Shayshez/1uO_c-mk2/README.md

# 1uO_c-mk2
Version 2 for 1uO_c, include VOR system and front usb

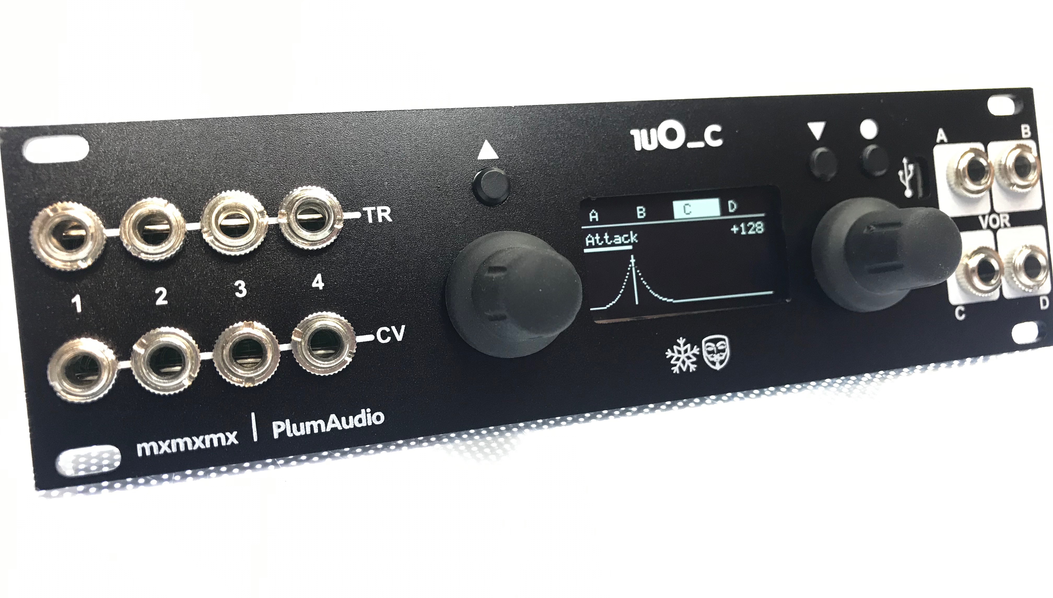
[picture p1: 1UO_C-MK2.jpeg]
1uO_c
