Shayshez/1uO_c-mk2/1uO_c_2.2_BOM.xlsx

Qty | Value | Device | Package | Parts | Description | MOUSER_PART_NUMBER | ARROW_PRICE-STOCK | AVAILABILITY | DESCRIPTION | HEIGHT | MANUFACTURER_NAME | MANUFACTURER_PART_NUMBER | MF | MP | MPN | PACKAGE | PRICE | RS_PART_NUMBER | RS_PRICE-STOCK | SPICEPREFIX | VALUE | WE-NUMBER
 | Resistors 0603 1%
6 | 100R | R-EU_R0603 | R0603 | R23, R25, R33, R41, R44, R45 | RESISTOR, European symbol | 603-RC0603FR-07100RL |  |  |  |  |  |  |  |  |  |  |  |  |  | R
4 | 220R | R-EU_R0603 | R0603 | R1, R3, R5, R6 | RESISTOR, European symbol | 603-RC0603FR-07220RL |  |  |  |  |  |  |  |  |  |  |  |  |  | R
3 | 510R | R-EU_R0603 | R0603 | R15, R17, R47 | RESISTOR, European symbol | 603-RC0603FR-07510RL |  |  |  |  |  |  |  |  |  |  |  |  |  | R
1 | 2K | R-EU_R0603 | R0603 | R18 | RESISTOR, European symbol | 603-RC0603FR-072KL |  |  |  |  |  |  |  |  |  |  |  |  |  | R
2 | 10k | R-EU_R0603 | R0603 | R13, R43 | RESISTOR, European symbol | 603-AC0603FR-1010KL |  |  |  |  |  |  |  |  |  |  |  |  |  | R
4 | 24K | R-EU_R0603 | R0603 | R9, R10, R11, R12 | RESISTOR, European symbol | 603-RC0603FR-0724KL |  |  |  |  |  |  |  |  |  |  |  |  |  | R
8 | 33K | R-EU_R0603 | R0603 | R20, R22, R27, R30, R32, R35, R36, R40 | RESISTOR, European symbol | 603-RC0603FR-1333KL |  |  |  |  |  |  |  |  |  |  |  |  |  | R
5 | 75K | R-EU_R0603 | R0603 | R14, R21, R28, R39, R42 | RESISTOR, European symbol | 603-AC0603FR-0775KL |  |  |  |  |  |  |  |  |  |  |  |  |  | R
13 | 100K | R-EU_R0603 | R0603 | R2, R4, R7, R8, R16, R19, R24, R26, R29, R31, R34, R37, R38 | RESISTOR, European symbol | 603-RC0603FR-07100KL |  |  |  |  |  |  |  |  |  |  |  |  |  | R
 | Caps MLCC
4 | 22p | C-EUC0603 | C0603 | C5, C6, C11, C12 | CAPACITOR, European symbol | 80-C0603C220J5G7411 (https://www.mouser.co.il/ProductDetail/KEMET/C0603C220J5GAC7411?qs=sGAEpiMZZMtJOOgnx%2fXJmejeuawQ%252btGe)
4 | 560p | C-EUC0603 | C0603 | C31, C32, C34, C35 | CAPACITOR, European symbol | 581-06035A561G
17 | 100n | C-EUC0603 | C0603 | C7, C8, C9, C10, C13, C14, C15, C17, C18, C19, C20, C25, C26, C29, C30, C33, C37 | CAPACITOR, European symbol | 80-C0603C104K3NAUTO (https://www.mouser.co.il/ProductDetail/KEMET/C0603C104K3NACAUTO)
3 | 470n | C-EUC0603 | C0603 | C16, C21, C22 | CAPACITOR, European symbol | 963-UMK107B7474KA-TR (https://www.mouser.co.il/ProductDetail/TDK/CGA3E3X7R1H474K080AB)
2 | 1uF | C-EUC0603 | C0603 | C27, C28 | CAPACITOR, European symbol | 603-CC603KRX5R8BB105 (https://www.mouser.co.il/ProductDetail/Yageo/CC0603KRX5R8BB105)
1 | 10uF | C-EUC0603 | C0603 | C36 | CAPACITOR, European symbol | 810-C1608X5R1A106K
2 | 10uF | C-EUC1206K | C1206K | C23, C24 | CAPACITOR, European symbol | 963-TMK316BJ106ML-T (https://www.mouser.co.il/ProductDetail/963-TMK316BJ106ML-T)
 | Caps Electrolytics
2 | 10uF | CPOL-EUB | PANASONIC_B | C1, C4 | POLARIZED CAPACITOR, European symbol | 667-EEE-FK1H100SR (https://www.mouser.co.il/ProductDetail/Panasonic/EEE-FK1H100SR) |  |  |  |  |  |  |  |  |  |  |  |  |  | C
1 | 10uF | CPOL-USA | PANASONIC_A | C40 | POLARIZED CAPACITOR, American symbol | 647-UWX1C100MCL2
2 | 22uF | CPOL-EUC | PANASONIC_C | C2, C3 | POLARIZED CAPACITOR, European symbol | 667-EEE-FK1H220SR (https://www.mouser.co.il/ProductDetail/Panasonic/EEE-FK1H220SR) |  |  |  |  |  |  |  |  |  |  |  |  |  | C
 | Inductor
1 | 10uH | WE-LQ_1210_744032001 | WE-LQ_M | L1 | SMD Inductor | 963-LB3218T100K (https://www.mouser.com/Search/ProductDetail.aspx) |  |  |  |  |  |  |  |  |  |  |  |  |  |  |  | 744032001/1uH
 | Chips
2 | 1N5819HW | DIODE_DIODE-SOD123 | DIODE_SOD123 | D1, D2 | DIODE | 621-1N5819HW-F (https://www.mouser.co.il/ProductDetail/Diodes-Incorporated/1N5819HW-7-F)
1 | ADP150AUJZ-3.3-R7 | ADP150AUJZ-3.3-R7 | SOT95P280X100-5N | U2 | IC REG LINEAR 2V 150MA 5TSOT | 584-ADP150AUJZ-3.3R7 |  | Good | LDO Regulator Pos 2V 0.15A 5-Pin TSOT T/R |  |  |  | Analog Devices | ADP150AUJZ-2.0-R7 |  | TSOT-23 Analog Devices | 0.65 USD
1 | DAC8565IAPW | DAC8565IAPW | SOP65P640X120-16N | U1 | Quad Channel DAC | 595-DAC8565IAPW (https://www.mouser.co.il/ProductDetail/Texas-Instruments/DAC8565IAPW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) |  | Good | 16-Bit, Quad Channel, Ultra-Low Glitch, Voltage Output DAC with 2.5V, 2ppm/C Internal eference 16-TSSOP -40 to 105 |  |  |  | Texas Instruments | DAC8565IAPW |  | TSSOP-16 Texas Instruments | 10.78 USD
1 | LD1117S50TR | LD1117S50TR | SOT223 | U3 | http://octopart.com/ld1117s50tr-stmicroelectronics-529395 | 511-LD1117S50 |  | Good | LD1117 Series 1300 mA 5 V Fixed Output Positive Voltage LDO Regulator - SOT-223 |  |  |  | STMicroelectronics | LD1117S50TR |  | SOT-223 STMicroelectronics | 0.19 USD
1 | LM321MF | LM321MF | SOT23-5 | IC7 | Low Power Single Op Amp | LM321MF/NOPB (https://www.mouser.co.il/ProductDetail/Texas-Instruments/LM321MF-NOPB?qs=sGAEpiMZZMvu8NZDyZ4K0QTEfSGysGd%252B)
1 | LM4040-5V | LM4041B12DBZ | DBZ_R-PDSO-G3 | IC3 | PRECISION MICROPOWER SHUNT VOLTAGE REFERENCE | 926-LM4040DIM350NOPB (https://www.mouser.co.il/ProductDetail/Texas-Instruments/LM4040DIM3-50-NOPB)
2 | MCP6002SMT | MCP6002SMT | SOIC8 | IC4, IC5 | Dual General Op Amp | 579-MCP6002T-I/SN (https://www.mouser.co.il/ProductDetail/Microchip-Technology/MCP6002T-I-SN?qs=sGAEpiMZZMsUzhEcHltCuY6YBL510a4u)
1 | MIC803-46D2VM3TR | MIC803-46D2VM3TR | SOT95P230X110-3N | IC6 | 3-pin Microprocessor Supervosor Circui | MIC803-46D2VM3TR |  |  | 3-pin Microprocessor Supervosor Circui | mm | Micrel | MIC803-46D2VM3TR
4 | MMBT3904LT1G | SMD-TRANSISTORS-NPN-40V-200MA-MMBT3904LT1G(SOT-23) | SOT-23 | Q1, Q2, Q3, Q4 | 305010013 | 863-MMBT3904LT1G (https://www.mouser.co.il/ProductDetail/ON-Semiconductor/MMBT3904LT1G) |  |  |  |  |  |  |  |  | MMBT3904LT1G |  |  |  |  |  | MMBT3904LT1G
2 | TL072 | TL072D | SO08 | IC1, IC2 | OP AMP | 595-TL072CDR (https://www.mouser.co.il/ProductDetail/Texas-Instruments/TL072CDR?qs=sGAEpiMZZMtYFXwiBRPs0zzUsTTH4TUq)
 | Misc
1 | 1X40 Pin Header | Theensy / OLED connector
1 | POWER HEADER 10 PINS | Pin headers 2.54mm 2X5 | POWER | J$1
2 | PEC11RPEC11R | PEC11RPEC11R | PEC11R | ENC_L, ENC_R | Incremental encoder 24 detents 24 pulses Bourns 24 Pulse Incremental Mechanical Rotary Encoder with a 6 mm Flat Shaft (Not Indexed), Through Hole | 858-EN11-HSM1BF20 (https://www.mouser.co.il/ProductDetail/858-EN11-HSM1BF20)
1 | TEENSY_3.2_USB_DAC_RESET | TEENSY_3.2_USB_DAC_RESET | TEENSY_3.2_USB_DAC_RESET | TEENSY3.2 |  | DEV-13736 (https://www.mouser.co.il/ProductDetail/SparkFun/DEV-13736?qs=sGAEpiMZZMuWWq7rhECaKVjnUlbUDjFgBj37EAXueZA%3D)
1 | USB_BOARD | USB_BOARD | MICRO-USB-BOARD | U$1
1 | USB Connector | USB Connector Type B micro, VERT - DIP | Wurth Elektronik 614105150621 | Wurth Elektronik 614105150621 | USB Connectors WR-COM USB Micro THT Type AB Vertical | 710-614105150621
3 |  | TACT Switches | E-switch TL1105SPF250Q | SW_B, SW_T, SW_VOR | Momentary Switch | 612-TL1105SP-250 (https://www.mouser.co.il/ProductDetail/612-TL1105SP-250)
3 |  | TACT Switches caps | E-switch 1RBLK | SW_B, SW_T, SW_VOR |  | 12-1R-BK (https://www.mouser.co.il/ProductDetail/612-1R-BK)
1 | Plum 1U_1.3OLED_2 | Plum 1U_1.3OLED_2 |  | OLED | https://github.com/Shayshez/1_3_OLED_FOR_1U
1 | OLED SCREEN |  |  |  | https://github.com/Shayshez/1_3_OLED_FOR_1U
12 | PJ301_THONKICONN | PJ301_THONKICONN | WQP_PJ_301M | CV1, CV2, CV3, CV4, CV_A, CV_B, CV_C, CV_D, TR1, TR2, TR3, TR4
