Shayshez/1uO_c-mk2/1uO_c_v_2.2.brd

## EAGLE design 1uO_c_v_2.2.brd (2019-11-25)

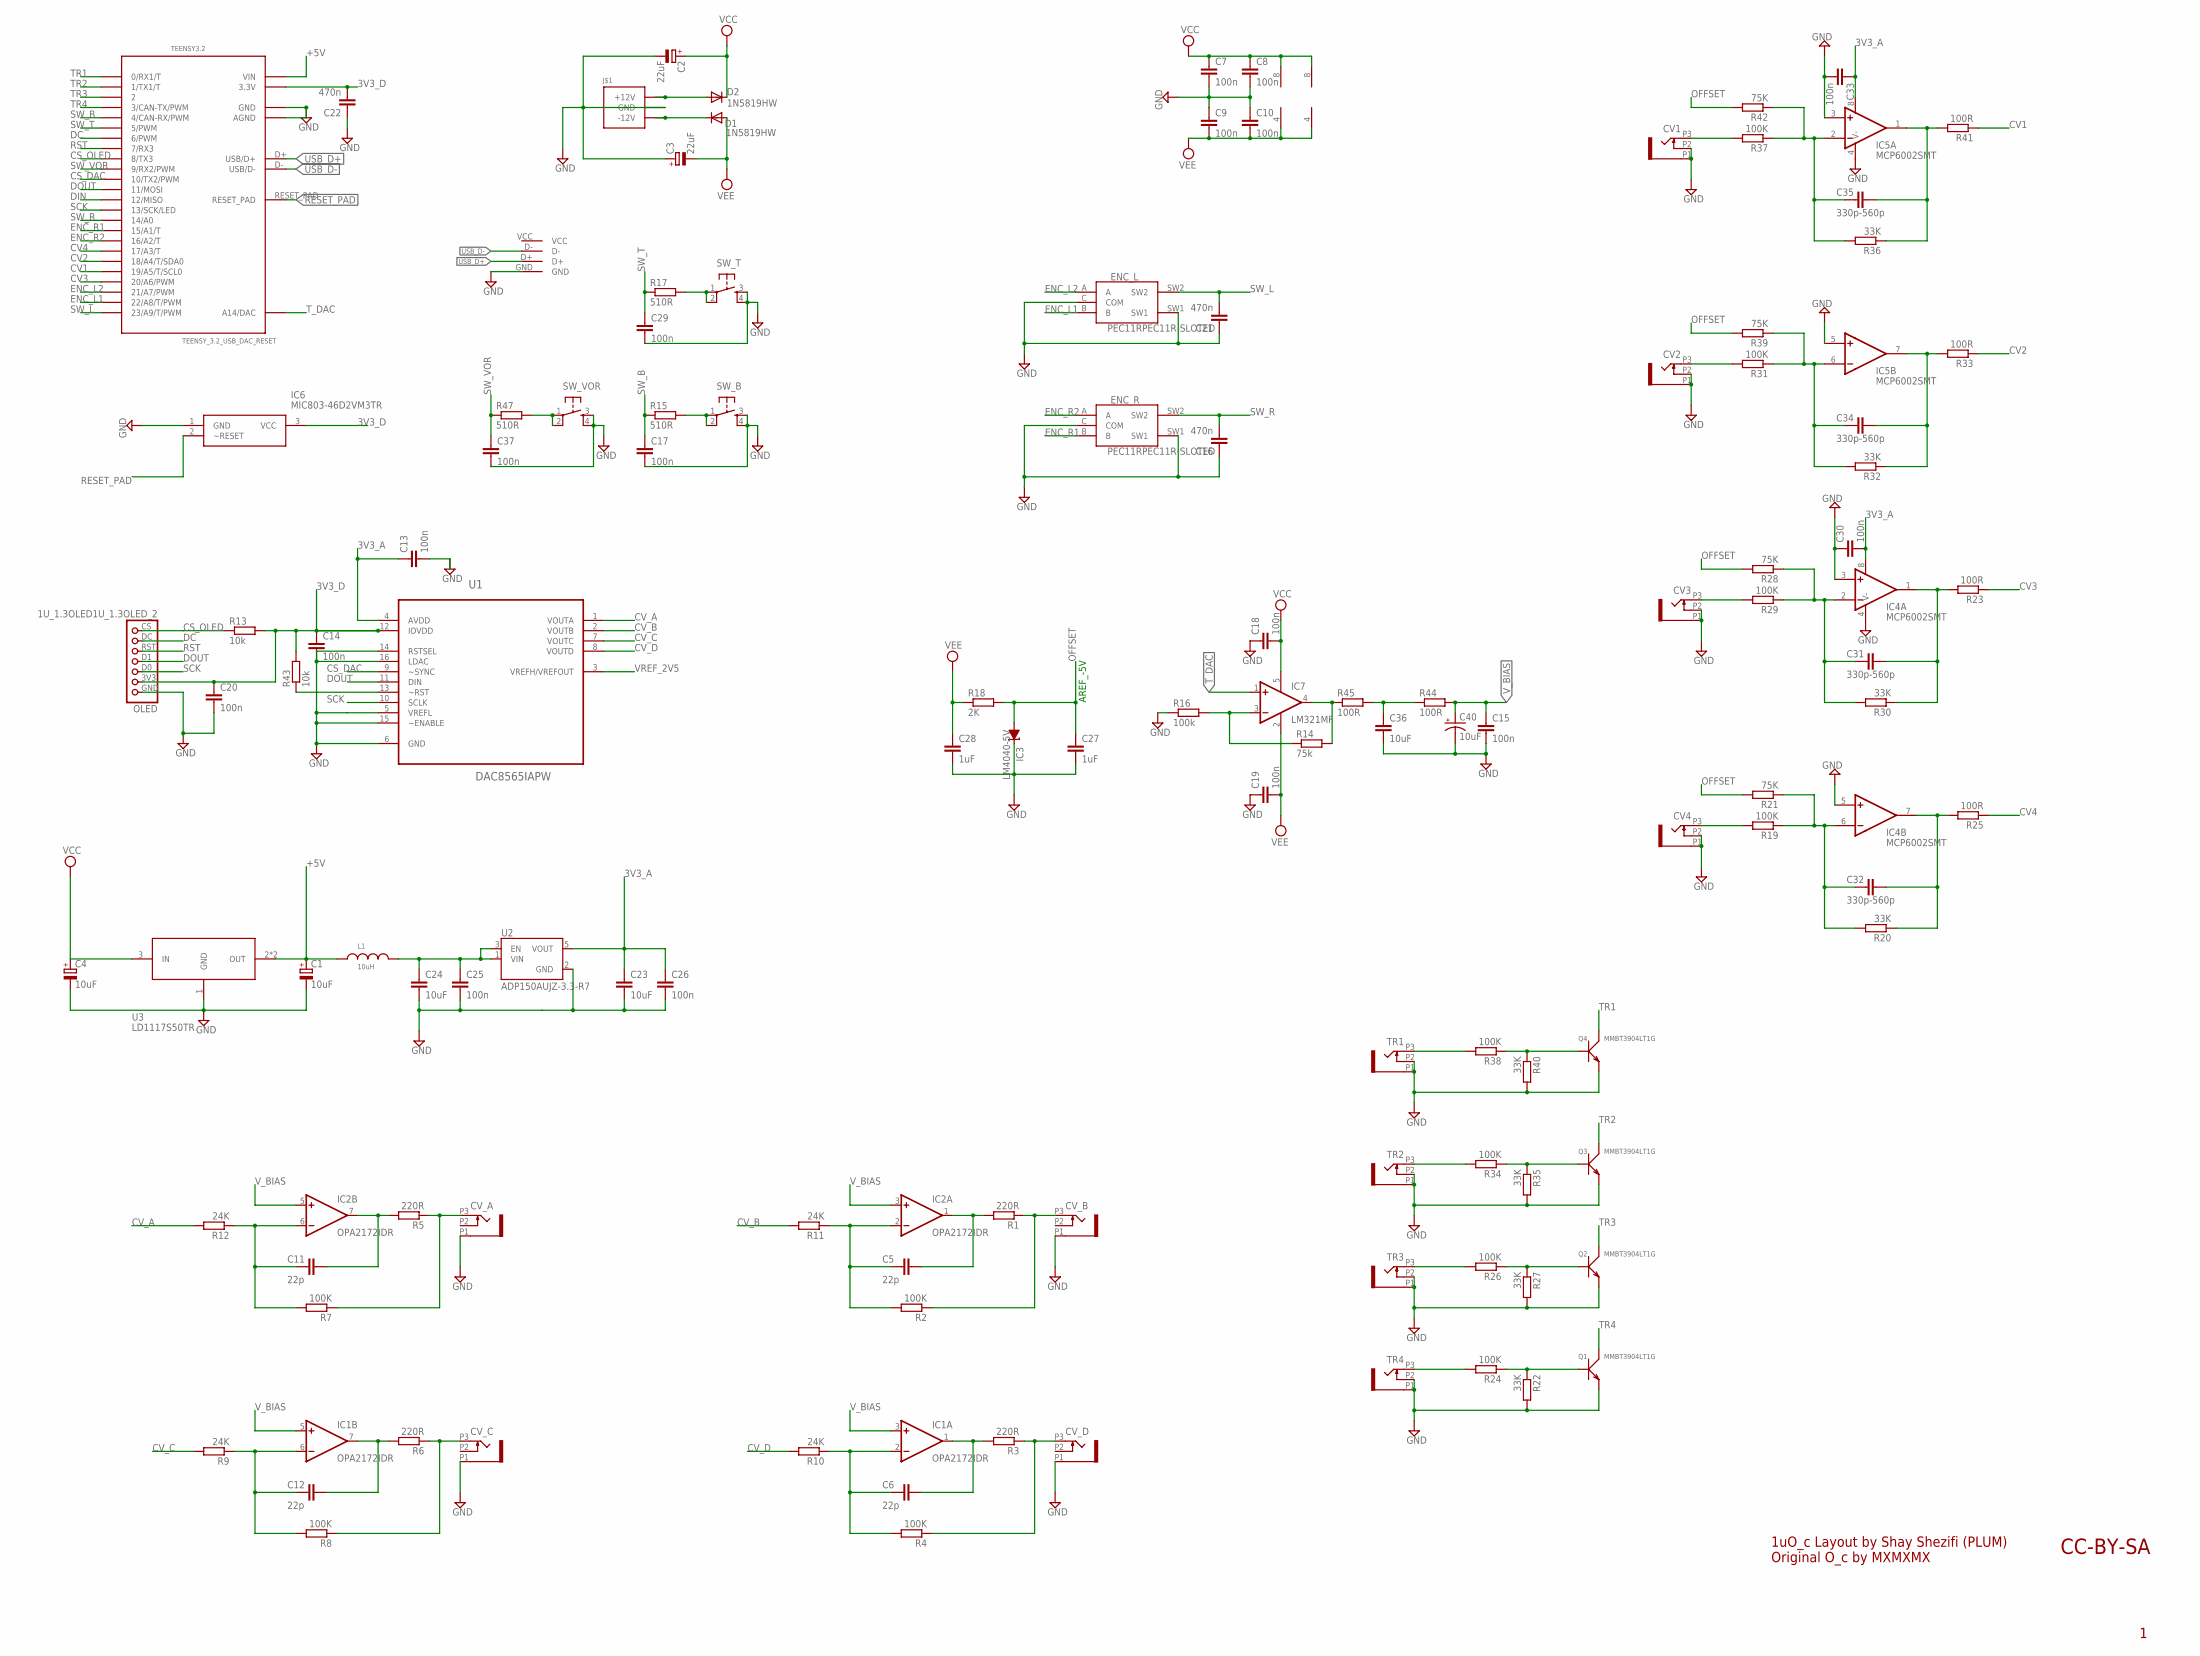
[picture p2: schematic 1uO_c_v_2.2.sch]

Parts:
C1, C4: 10uF; PANASONIC_B
C2, C3: 22uF; PANASONIC_C
C5, C6, C11, C12: 22p; C0603
C7, C8, C9, C10, C13, C14, C15, C17, C18, C19, C20, C25, C26, C29, C30, C33, C37: 100n; C0603
C16, C21, C22: 470n; C0603
C23, C24: 10uF; C1206K
C27, C28: 1uF; C0603
C31, C32, C34, C35: 330p-560p; C0603
C36: 10uF; C0603
C40: 10uF; PANASONIC_A
CV1, CV2, CV3, CV4: OG-PJ301_PJ301_THONKICONN; OG-PJ301_WQP_PJ_301M6_NO_HOLE
CV_A: OG-PJ301_PJ301_THONKICONN; OG-PJ301_WQP_PJ_301M6_NO_HOLE
CV_B: OG-PJ301_PJ301_THONKICONN; OG-PJ301_WQP_PJ_301M6_NO_HOLE
CV_C: OG-PJ301_PJ301_THONKICONN; OG-PJ301_WQP_PJ_301M6_NO_HOLE
CV_D: OG-PJ301_PJ301_THONKICONN; OG-PJ301_WQP_PJ_301M6_NO_HOLE
D1, D2: 1N5819HW; DIODE_SOD123
ENC_L: PEC11RPEC11R-SLOTED; PEC11R-SLOTED
ENC_R: PEC11RPEC11R-SLOTED; PEC11R-SLOTED
IC1, IC2: OPA2172IDR; SO08
IC3: LM4040-5V; DBZ_R-PDSO-G3
IC4, IC5: MCP6002SMT; SOIC8
IC6: MIC803-46D2VM3TR; SOT95P230X110-3N
IC7: LM321MF; SOT23-5
J$1: POWER_SIMPLE10; POWER_10
L1: 10uH; WE-LQ_M
OLED: 1U_1.3OLED1U_1.3OLED_2; 1U_1.3OLED_2
Q1, Q2, Q3, Q4: MMBT3904LT1G; SOT-23
R1, R3, R5, R6: 220R; R0603
R2, R4, R7, R8, R19, R24, R26, R29, R31, R34, R37, R38: 100K; R0603
R9, R10, R11, R12: 24K; R0603
R13, R43: 10k; R0603
R14: 75k; R0603
R15, R17, R47: 510R; R0603
R16: 100k; R0603
R18: 2K; R0603
R20, R22, R27, R30, R32, R35, R36, R40: 33K; R0603
R21, R28, R39, R42: 75K; R0603
R23, R25, R33, R41, R44, R45: 100R; R0603
SW_B: TAC_SWITCHPTH; TACTILE-PTH
SW_T: TAC_SWITCHPTH; TACTILE-PTH
SW_VOR: TAC_SWITCHPTH; TACTILE-PTH
TEENSY3.2: TEENSY_3.2_USB_DAC_RESET
TR1, TR2, TR3, TR4: OG-PJ301_PJ301_THONKICONN; OG-PJ301_WQP_PJ_301M6_NO_HOLE
U1: DAC8565IAPW; SOP65P640X120-16N
U2: ADP150AUJZ-3.3-R7; SOT95P280X100-5N
U3: LD1117S50TR; SOT223
U$1: USB_BOARD; MICRO-USB-BOARD

Connections:
3V3_A: C13.1, C23.1, C26.1, C30.2, C33.1, IC4.8 (V+), IC5.8 (V+), U1.4 (AVDD), U2.5 (VOUT)
3V3_D: C14.1, C20.1, C22.2, IC6.3 (VCC), OLED.3V3, R13.2, R43.2, TEENSY3.2.3.3V, U1.12 (IOVDD)
+5V: C1.+, L1.1, TEENSY3.2.VIN, U3.2 (OUT), U3.4 (OUT)
CS_DAC: TEENSY3.2.10 (10/TX2/PWM), U1.9 (~SYNC)
CS_OLED: OLED.CS, R13.1, TEENSY3.2.8 (8/TX3)
CV1: R41.1, TEENSY3.2.19/A5 (19/A5/T/SCL0)
CV2: R33.1, TEENSY3.2.18/A4 (18/A4/T/SDA0)
CV3: R23.1, TEENSY3.2.20/A6 (20/A6/PWM)
CV4: R25.1, TEENSY3.2.17/A3 (17/A3/T)
CV_A: R12.2, U1.1 (VOUTA)
CV_B: R11.2, U1.2 (VOUTB)
CV_C: R9.2, U1.7 (VOUTC)
CV_D: R10.2, U1.8 (VOUTD)
DC: OLED.DC, TEENSY3.2.6 (6/PWM)
DIN: TEENSY3.2.12 (12/MISO)
DOUT: OLED.D1, TEENSY3.2.11 (11/MOSI), U1.11 (DIN)
ENC_L1: ENC_L.B, TEENSY3.2.22/A8 (22/A8/T/PWM)
ENC_L2: ENC_L.A, TEENSY3.2.21/A7 (21/A7/PWM)
ENC_R1: ENC_R.B, TEENSY3.2.15/A1 (15/A1/T)
ENC_R2: ENC_R.A, TEENSY3.2.16/A2 (16/A2/T)
GND: C1.-, C2.-, C3.+, C4.-, C7.2, C8.2, C9.1, C10.1, C13.2, C14.2, C15.2, C16.1, C17.2, C18.1, C19.1, C20.2, C21.1, C22.1, C23.2, C24.2, C25.2, C26.2, C27.2, C28.2, C29.2, C30.1, C33.2, C36.2, C37.2, C40.-, CV1.P1 (1), CV1.P2 (2), CV2.P1 (1), CV2.P2 (2), CV3.P1 (1), CV3.P2 (2), CV4.P1 (1), CV4.P2 (2), CV_A.P1 (1), CV_B.P1 (1), CV_C.P1 (1), CV_D.P1 (1), ENC_L.C (COM), ENC_L.SW1, ENC_R.C (COM), ENC_R.SW1, IC3.1 (C), IC4.3 (+IN), IC4.4 (V-), IC4.5 (+IN), IC5.3 (+IN), IC5.4 (V-), IC5.5 (+IN), IC6.1 (GND), J$1.3 (GND), J$1.4 (GND), J$1.5 (GND), J$1.6 (GND), J$1.7 (GND), J$1.8 (GND), OLED.GND, Q1.2 (E), Q2.2 (E), Q3.2 (E), Q4.2 (E), R16.1, R22.2, R27.2, R35.2, R40.2, SW_B.3, SW_B.4, SW_T.3, SW_T.4, SW_VOR.3, SW_VOR.4, TEENSY3.2.AGND, TEENSY3.2.GND, TR1.P1 (1), TR1.P2 (2), TR2.P1 (1), TR2.P2 (2), TR3.P1 (1), TR3.P2 (2), TR4.P1 (1), TR4.P2 (2), U1.5 (VREFL), U1.6 (GND), U1.14 (RSTSEL), U1.15 (~ENABLE), U1.16 (LDAC), U2.2 (GND), U3.1 (GND), U$1.GND
unnamed: D1.C, J$1.1 (-12V), J$1.2 (-12V)
unnamed: D2.A, J$1.9 (+12V), J$1.10 (+12V)
unnamed: C24.1, C25.1, L1.2, U2.1 (VIN), U2.3 (EN)
unnamed: CV1.P3 (3), R37.2
unnamed: C35.2, IC5.2 (-IN), R36.2, R37.1, R42.1
unnamed: C35.1, IC5.1 (OUT), R36.1, R41.2
unnamed: R17.2, SW_T.1, SW_T.2
unnamed: CV2.P3 (3), R31.2
unnamed: R15.2, SW_B.1, SW_B.2
unnamed: C34.2, IC5.6 (-IN), R31.1, R32.2, R39.1
unnamed: C34.1, IC5.7 (OUT), R32.1, R33.2
unnamed: CV3.P3 (3), R29.2
unnamed: C31.2, IC4.2 (-IN), R28.1, R29.1, R30.2
unnamed: C31.1, IC4.1 (OUT), R23.2, R30.1
unnamed: CV4.P3 (3), R19.2
unnamed: C32.2, IC4.6 (-IN), R19.1, R20.2, R21.1
unnamed: C32.1, IC4.7 (OUT), R20.1, R25.2
unnamed: R38.2, TR1.P3 (3)
unnamed: Q4.1 (B), R38.1, R40.1
unnamed: R34.2, TR2.P3 (3)
unnamed: Q3.1 (B), R34.1, R35.1
unnamed: R26.2, TR3.P3 (3)
unnamed: Q2.1 (B), R26.1, R27.1
unnamed: R24.2, TR4.P3 (3)
unnamed: Q1.1 (B), R22.1, R24.1
unnamed: C5.2, IC2.2 (-IN), R2.2, R11.1
unnamed: C11.2, IC2.6 (-IN), R7.2, R12.1
unnamed: C11.1, IC2.7 (OUT), R5.2
unnamed: CV_A.P3 (3), R5.1, R7.1
unnamed: C5.1, IC2.1 (OUT), R1.2
unnamed: CV_B.P3 (3), R1.1, R2.1
unnamed: C12.2, IC1.6 (-IN), R8.2, R9.1
unnamed: C12.1, IC1.7 (OUT), R6.2
unnamed: CV_C.P3 (3), R6.1, R8.1
unnamed: C6.2, IC1.2 (-IN), R4.2, R10.1
unnamed: C6.1, IC1.1 (OUT), R3.2
unnamed: CV_D.P3 (3), R3.1, R4.1
unnamed: R43.1, U1.13 (~RST)
unnamed: IC7.3 (-IN), R14.1, R16.2
unnamed: IC7.4 (OUT), R14.2, R45.1
unnamed: C36.1, R44.1, R45.2
unnamed: R47.2, SW_VOR.1, SW_VOR.2
OFFSET: C27.1, IC3.2 (A), R18.2, R21.2, R28.2, R39.2, R42.2
RESET_PAD: IC6.2 (~RESET), TEENSY3.2.RESET_PAD
RST: OLED.RST, TEENSY3.2.7 (7/RX3)
SCK: OLED.D0, TEENSY3.2.13 (13/SCK/LED), U1.10 (SCLK)
SW_B: C17.1, R15.1, TEENSY3.2.4 (4/CAN-RX/PWM)
SW_L: C21.2, ENC_L.SW2, TEENSY3.2.23/A9 (23/A9/T/PWM)
SW_R: C16.2, ENC_R.SW2, TEENSY3.2.14/A0
SW_T: C29.1, R17.1, TEENSY3.2.5 (5/PWM)
SW_VOR: C37.1, R47.1, TEENSY3.2.9 (9/RX2/PWM)
TR1: Q4.3 (C), TEENSY3.2.0 (0/RX1/T)
TR2: Q3.3 (C), TEENSY3.2.1 (1/TX1/T)
TR3: Q2.3 (C), TEENSY3.2.2
TR4: Q1.3 (C), TEENSY3.2.3 (3/CAN-TX/PWM)
T_DAC: IC7.1 (+IN), TEENSY3.2.RESET/DAC (A14/DAC)
USB_D+: TEENSY3.2.D+ (USB/D+), U$1.D+
USB_D-: TEENSY3.2.D- (USB/D-), U$1.D-
VCC: C2.+, C4.+, C7.1, C8.1, C18.2, D2.C, IC1.8 (V+), IC2.8 (V+), IC7.5 (V+), U3.3 (IN)
VEE: C3.-, C9.2, C10.2, C19.2, C28.1, D1.A, IC1.4 (V-), IC2.4 (V-), IC7.2 (V-), R18.1
VREF_2V5: U1.3 (VREFH/VREFOUT)
V_BIAS: C15.1, C40.+, IC1.3 (+IN), IC1.5 (+IN), IC2.3 (+IN), IC2.5 (+IN), R44.2

Notes on the sheet:
AREF_-5V
1uO_c Layout by Shay Shezifi (PLUM) Original O_c by MXMXMX
CC-BY-SA

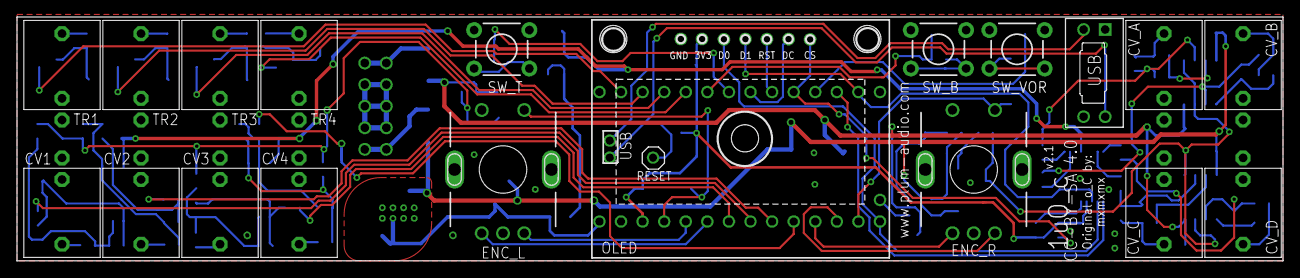
[picture p3: board 1uO_c_v_2.2.brd from above]

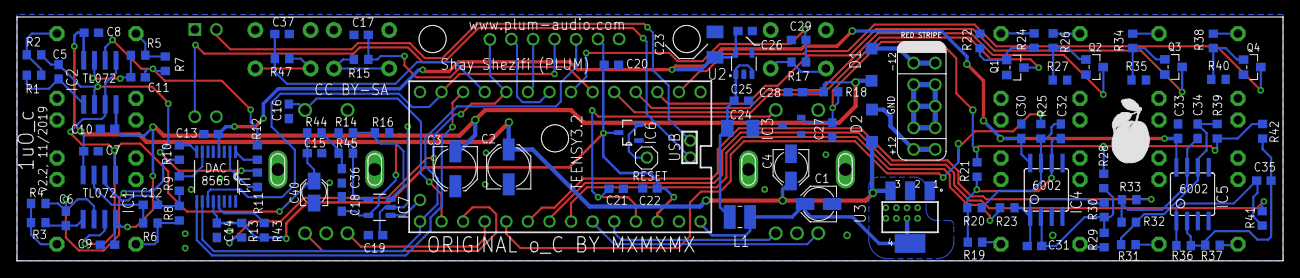
[picture p4: board 1uO_c_v_2.2.brd from below]

Board: 2 copper layers, 149.0 x 28.7 mm, 122 parts (103 on the bottom side), 81 nets.
