Shayshez/1uO_c-mk2/(notices)

Notices in the files:
1uO_c_v_2.2.brd:
CC-BY-SA 4.0
parts and their libraries:
Wurth_Elektronik_Passive_rev17b: Copyright: Würth Elektronik
